seventhoctave/mini68k/README.md

# mini68k

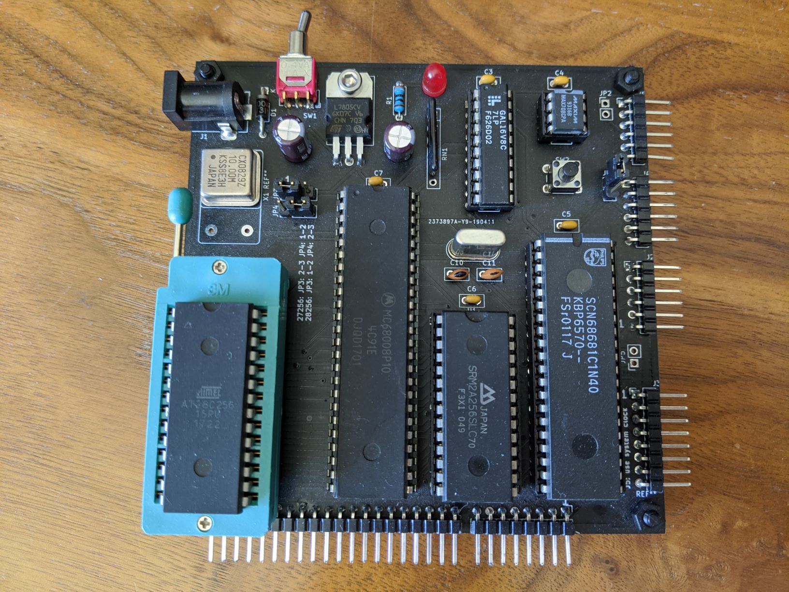
[picture p1: hw/100x100.jpg]
alt v1


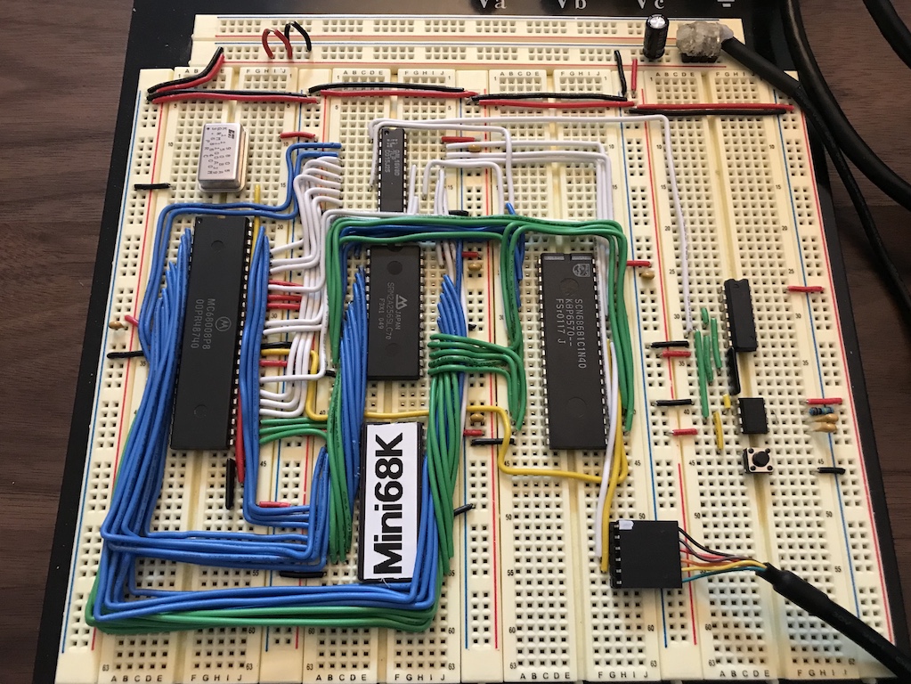
[picture p2: hw/breadboard.jpg]
alt breadboard


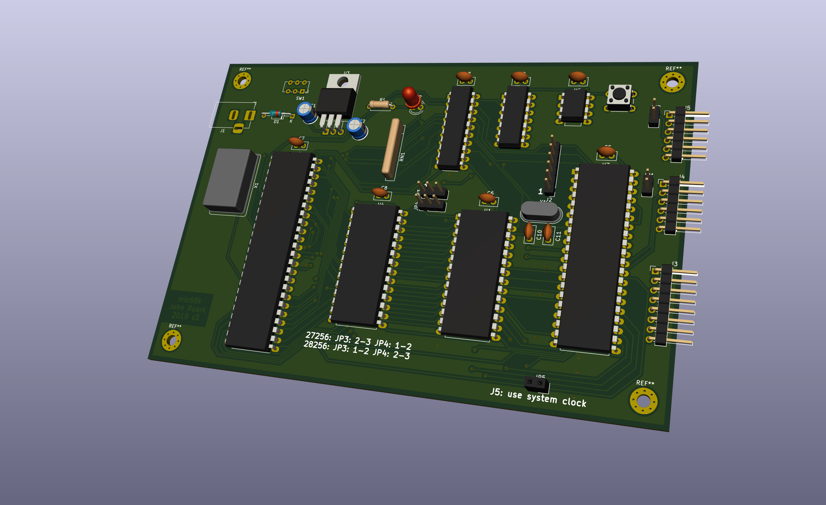
[picture p3: hw/mini68k.png]
alt 3d


based on http://www.christle.us/index.php?P=4
