seventhoctave/mini68k/hw/v1.jpg

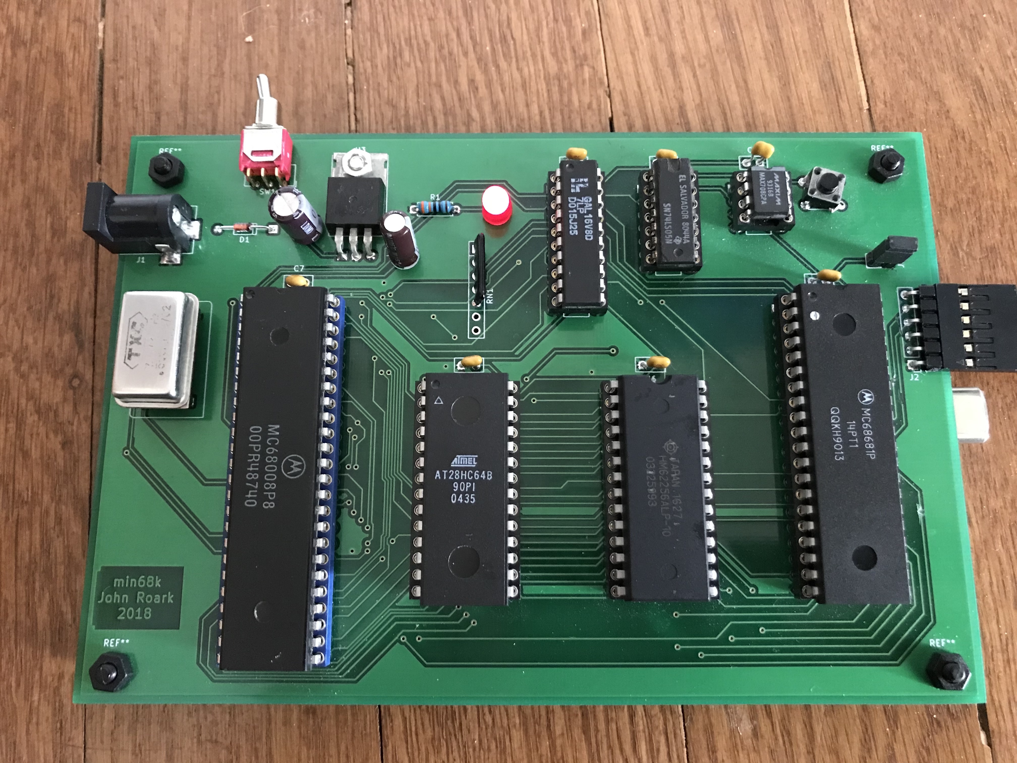
hw/v1.jpg
