seventhoctave/mini68k/hw/mini68k/mini68k.kicad_pcb

## KiCad design hw/mini68k/mini68k.kicad_pcb (2019-03-17)

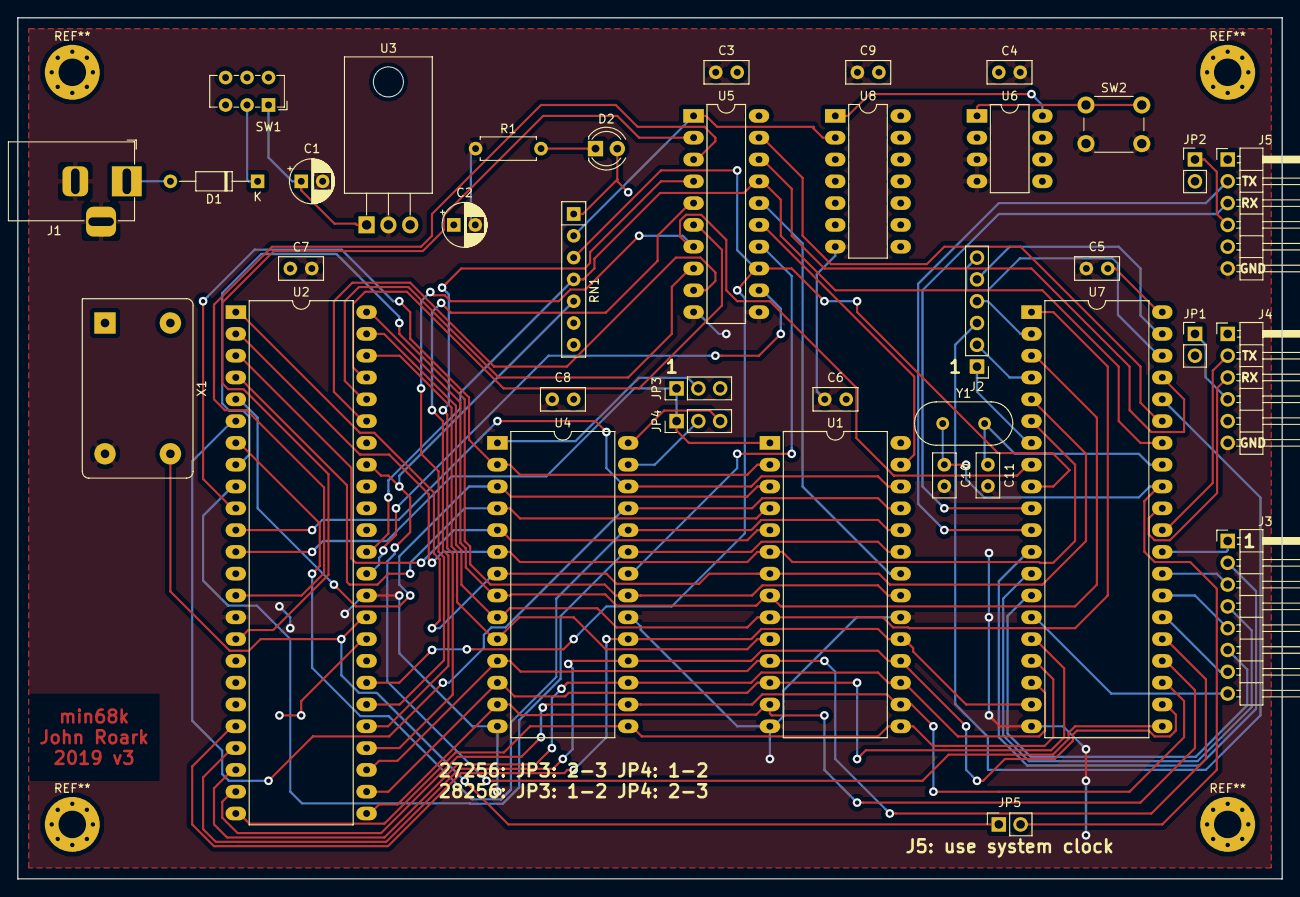
[picture p5: board mini68k.kicad_pcb from above]

Board: 2 copper layers, 147.3 x 100.3 mm, 37 parts (0 on the bottom side), 74 nets.

Parts:
C1: 100uF; CP_Radial_D5.0mm_P2.50mm
C2: 10uF; CP_Radial_D5.0mm_P2.50mm
C3, C4, C5, C6, C7, C8, C9: .1u; C_Disc_D5.0mm_W2.5mm_P2.50mm
C10: 5pf; C_Disc_D5.0mm_W2.5mm_P2.50mm
C11: 15pf; C_Disc_D5.0mm_W2.5mm_P2.50mm
D1: D_ALT; D_DO-35_SOD27_P10.16mm_Horizontal
D2: RED; LED_D4.0mm
J1: Jack-DC; BarrelJack_Horizontal
J2: 6-bit input port; PinHeader_1x06_P2.54mm_Vertical
J3: 8-bit output port; PinHeader_1x08_P2.54mm_Horizontal
J4: FTDI header COM1; PinHeader_1x06_P2.54mm_Horizontal
J5: FTDI header COM2; PinHeader_1x06_P2.54mm_Horizontal
JP1, JP2: Jumper; PinHeader_1x02_P2.54mm_Vertical
JP3, JP4: Jumper_3_Open; PinHeader_1x03_P2.54mm_Vertical
JP5: Jumper; PinSocket_1x02_P2.54mm_Vertical
R1: 330R; R_Axial_DIN0207_L6.3mm_D2.5mm_P7.62mm_Horizontal
RN1: 1k; R_Array_SIP7
SW1: SW_SPDT; SW_E-Switch_EG1271_DPDT
SW2: SW_Push; SW_PUSH_6mm
U1: HM62256BLP-7; DIP-28_W15.24mm_LongPads
U2: 68008D; DIP-48_W15.24mm_LongPads
U3: L7805; TO-220-3_Horizontal_TabDown
U4: 28C256/27C256; DIP-28_W15.24mm_LongPads
U5: GAL16V8; DIP-20_W7.62mm_LongPads
U6: MAX708CPA+; DIP-8_W7.62mm_LongPads
U7: 68681; DIP-40_W15.24mm_LongPads
U8: 74LS05; DIP-14_W7.62mm_LongPads
X1: 8 Mhz; Oscillator_DIP-14_LargePads
Y1: 3.6864 Mhz; Crystal_HC49-4H_Vertical

Connections:
A0: U1.10, U2.46, U4.10
A1: U1.9, U2.47, U4.9, U7.1
A2: U1.8, U2.48, U4.8, U7.3
A3: U1.7, U2.1, U4.7, U7.5
A4: U1.6, U2.2, U4.6, U7.6
A5: U1.5, U2.3, U4.5
A6: U1.4, U2.4, U4.4
A7: U1.3, U2.5, U4.3
A8: U1.25, U2.6, U4.25
A9: U1.24, U2.7, U4.24
A10: U1.21, U2.8, U4.21
A11: U1.23, U2.9, U4.23
A12: U1.2, U2.10, U4.2
A13: U1.26, U2.11, U4.26
A14: JP3.1, JP4.1, U1.1, U2.12
A15: U2.14, U5.3
A16: U2.16, U5.2
AS: U2.28, U5.4
CLK: JP5.1, U2.34, X1.8
DB0: U1.11, U2.27, U4.11, U7.25
DB1: U1.12, U2.26, U4.12, U7.16
DB2: U1.13, U2.25, U4.13, U7.24
DB3: U1.15, U2.24, U4.15, U7.17
DB4: U1.16, U2.23, U4.16, U7.23
DB5: U1.17, U2.22, U4.17, U7.18
DB6: U1.18, U2.21, U4.18, U7.22
DB7: U1.19, U2.20, U4.19, U7.19
DS: U2.29, U5.5
DTACK: RN1.3, U2.31, U5.13, U7.9
FC0: U2.45, U5.6
FC1: U2.44, U5.8
FC2: U2.43, U5.9
GND: C1.2, C2.2, C3.2, C4.2, C5.2, C6.2, C7.2, C8.2, C9.2, C10.2, C11.2, J1.2, J1.3, J4.6, J5.6, R1.1, SW2.2, U1.14, U1.20, U2.15, U2.35, U3.2, U4.14, U4.20, U5.10, U5.11, U6.3, U6.4, U7.20, U8.7, X1.7
HALT: U2.36, U5.12
IACK: U5.18, U7.37
INTR: RN1.5, U2.41, U7.21
IP0: J2.1, U7.7
IP1: J2.2, U7.4
IP2: J2.3, U7.36
IP3: J2.4, U7.2
IP4: J2.5, U7.39
IP5: J2.6, U7.38
MR: SW2.1, U6.1
unnamed: C1.1, SW1.1, U3.1
unnamed: D1.1, SW1.2
unnamed: D1.2, J1.1
unnamed: D2.1, R1.2
unnamed: J4.4, JP1.1
unnamed: J5.4, JP2.1
unnamed: U6.8, U8.1
OP0: J3.1, U7.29
OP1: J3.2, U7.12
OP2: J3.3, U7.28
OP3: J3.4, U7.13
OP4: J3.5, U7.27
OP5: J3.6, U7.14
OP6: J3.7, U7.26
OP7: J3.8, U7.15
R/W: U2.30, U5.7, U7.8
RAM_OE: U1.22, U5.16
RAM_WE: U1.27, U5.15
RESET: RN1.4, U2.37, U5.17, U7.34
ROM_OE: U4.22, U5.14
ROM_PIN1: JP3.2, U4.1
ROM_PIN27: JP4.2, U4.27
RST: RN1.2, U5.1, U8.2
RX1: J4.3, U7.31
RX2: J5.3, U7.10
TX1: J4.2, U7.30
TX2: J5.2, U7.11
UART_CS: U5.19, U7.35
VCC: C2.1, C3.1, C4.1, C5.1, C6.1, C7.1, C8.1, C9.1, D2.2, JP1.2, JP2.2, JP3.3, JP4.3, RN1.1, U1.28, U2.13, U2.33, U2.39, U2.40, U2.42, U3.3, U4.28, U5.20, U6.2, U7.40, U8.14, X1.14
X1: C10.1, JP5.2, U7.32, Y1.1
X2: C11.1, U7.33, Y1.2
