seventhoctave/mini68k/(commit log)

2018-06-13 print hex, dump mem, fill mem
2018-06-19 * intial checkin of kicad schematics
    [mini68k.kicad_pcb, mini68k.sch]
2018-06-20 * oscillator, gal
    [mini68k.sch]
2018-06-20 everything but reset and i/o
    [mini68k.sch]
2018-06-22 initial pcb layout
    [mini68k.kicad_pcb, mini68k.sch]
2018-06-22 initial layout
    [mini68k.kicad_pcb, mini68k.sch]
2018-06-22 routing complete
    [mini68k.kicad_pcb]
2018-06-23 3d model
    [mini68k.kicad_pcb]
2018-06-23 re-pour planes
    [mini68k.kicad_pcb]
2018-06-28 v2 fixes:
    - swapped rx/tx
    - reset switch
    - pullup RST
    - pin one of X1
    - remove VCC plane from under 7805
    [mini68k.kicad_pcb, mini68k.sch]
2019-03-10 KiCad 5
    [mini68k.kicad_pcb, mini68k.sch]
2019-03-10 update footprints, expose i/o from 68681
    [mini68k.kicad_pcb, mini68k.sch]
2019-03-11 run drc and fix issues
    [mini68k.kicad_pcb]
2019-03-11 better fills
    [mini68k.kicad_pcb, mini68k.sch]
2019-03-11 more updated footprints and 3d
    [mini68k.kicad_pcb, mini68k.sch]
2019-03-11 better 3d
    [mini68k.kicad_pcb, mini68k.sch]
2019-03-13 jumpers for 27256/28256
    [mini68k.kicad_pcb, mini68k.sch]
2019-03-15 update symbols
    [mini68k.sch]
2019-03-15 correct ram pinout... update symbols
    [mini68k.kicad_pcb, mini68k.sch]
2019-03-17 seperate crystal for DUART
    [mini68k.kicad_pcb, mini68k.sch]
2019-03-17 v1 pcb photo
2020-07-29 100x100 pcb image
